rkbrooks/vg64/schematic.png

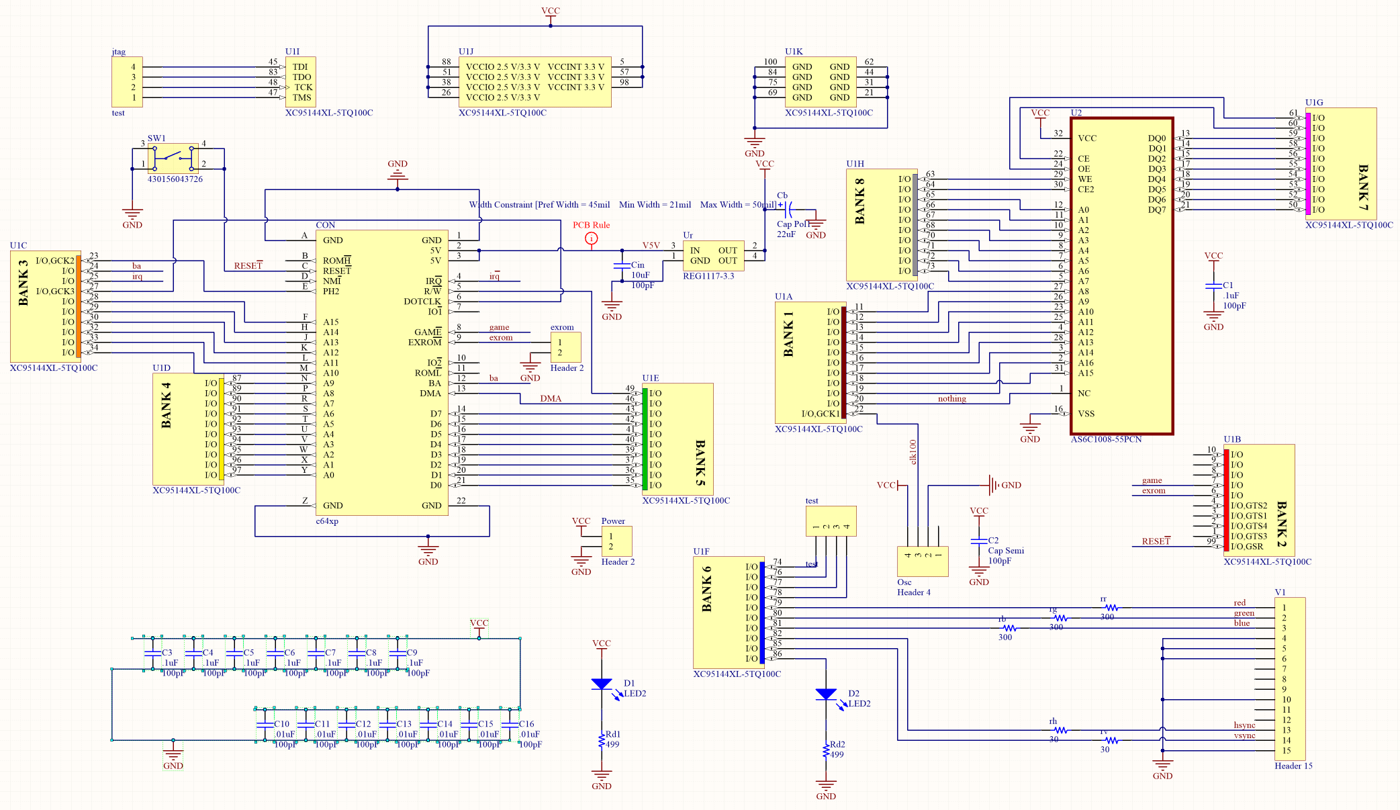
schematic.png
