rkbrooks/vg64/bottom cart with standoffs.stl

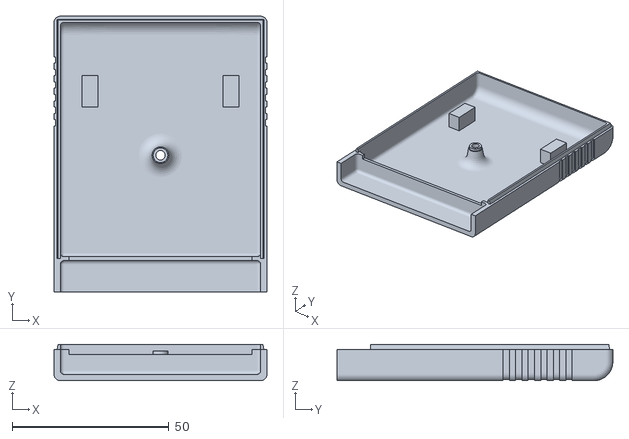
[picture p2: CAD file, 2021-06-07]
bottom cart with standoffs.stl
68.0 x 88.0 x 11.6
