rkbrooks/vg64/bigger vg64 cart top.stl

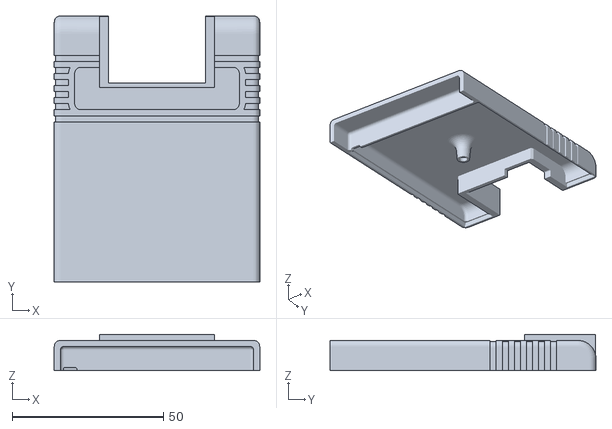
[picture p3: CAD file, 2021-06-07]
bigger vg64 cart top.stl
68.0 x 88.0 x 12.0
